gustavocelani/sense_pro/README.md

# Sense Pro

That project was developed in my period of scientific research on CDTTA (Development Center of Assistive Technology) of INATEL.

The propose was develop a open source project of a low coust protesis using 3D printing.
