gustavocelani/sense_pro/Pictures/README.md

# Pictures

There are some general pictures about the project.

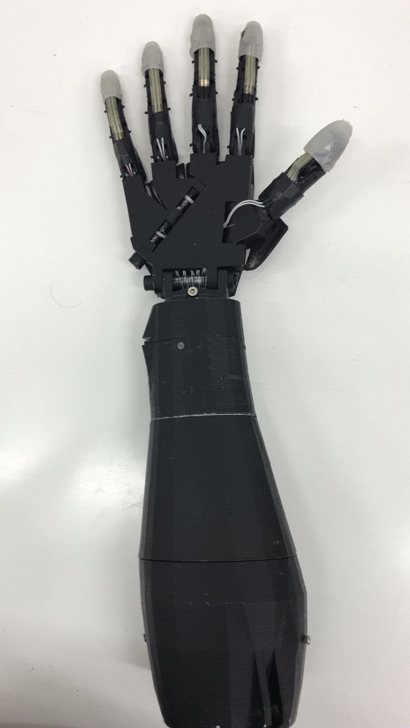
[picture p1: Pictures/Pic_4.jpg]
SensePro Prototype
