gustavocelani/sense_pro/FSR_vs_Piezoeletrico/README.md

# FSR (Force Sensor Resistive) VS Piezoeletric Sensor

That was a study about the differences beetween an FSR and Piezoeletric sensor.

Impiric tests was made to presents this resolts.

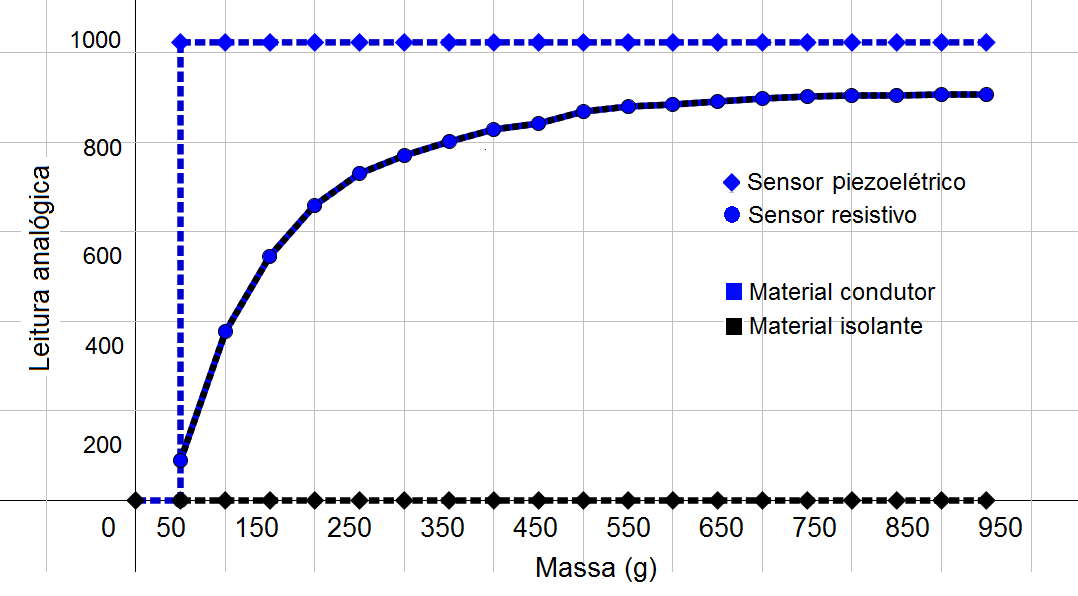
[picture p2: FSR_vs_Piezoeletrico/Comparative.png]
FSR vs Piezoeletric
