gustavocelani/sense_pro/Softwares/Application_Bluetooth_Version/README.md

# Sense Pro - Android Bluetooth Version

To use this software version, install the "SensePro_v05.apk" on your android device and upload "Embedded_Firmware.ino" on your AtMega.
