gustavocelani/sense_pro/Softwares/Sensors_Monitor/README.md

# Sense Pro - Sensors Monitor

This version was used to monitoring all sensors.

To use this software version, upload "Embedded_Firmware.ino" on your AtMega and run "Sensors_Monitor.pde" on your computer.

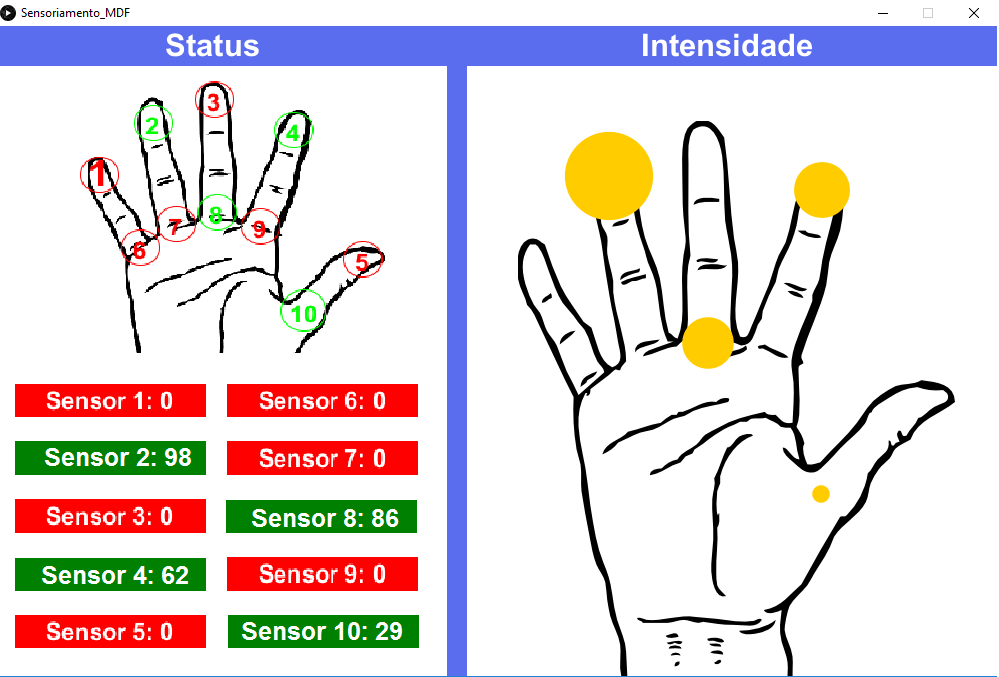
[picture p3: Softwares/Sensors_Monitor/Printscreen.png]
Software
