gustavocelani/sense_pro/Softwares/Status_Commands_Desktop/README.md

# Sense Pro - Status Commands

This version was used to monitoring all sensors status and control the prototype.

To use this software version, upload "Embedded_Firmware.ino" on your AtMega and run "Status_Commands_Desktop_v3.pde" on your computer.

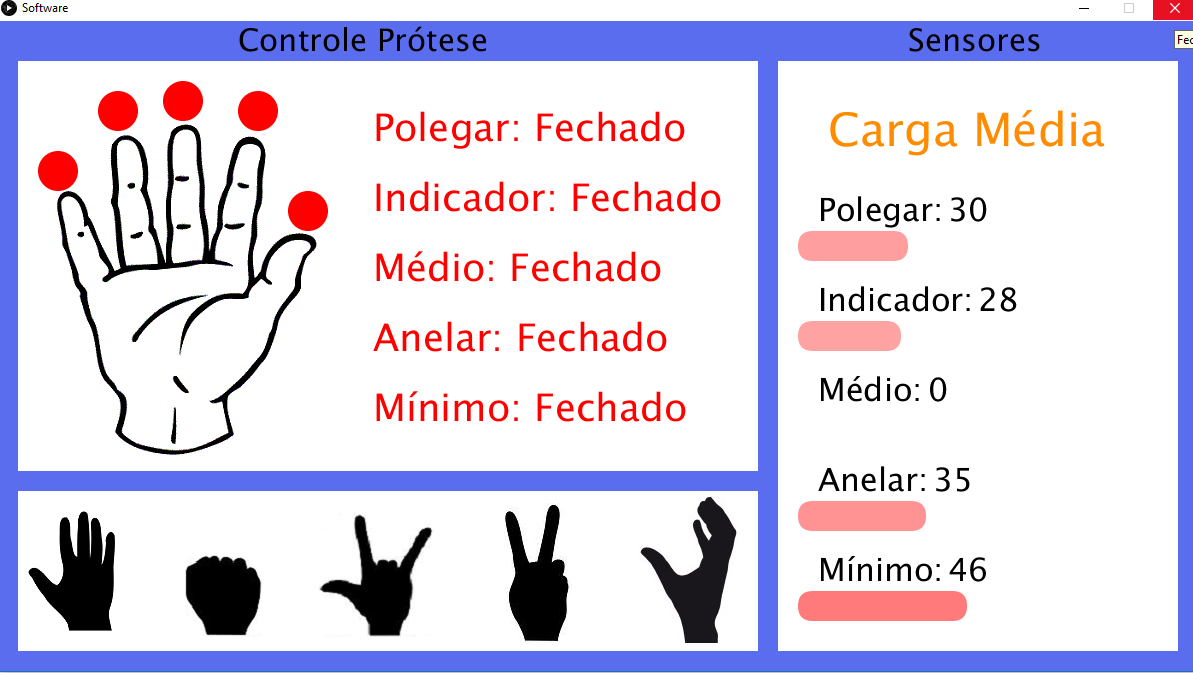
[picture p4: Softwares/Status_Commands_Desktop/Printscreen.png]
Software
