gustavocelani/sense_pro/Softwares/Sensors_Monitor/Sensors_Monitor_v2/README.md

# Sense Pro - Sensors Monitor

```
/* ************************************************************************
 *
 * Tittle: Sensors_Monitor_v2.pde
 *
 * Description:  Monitoring States of Sensors Graphcaly
 *
 * Version:      2
 * Date:         06/02/2016  09:41:02
 * Author:       Gustavo Celani
 * Organization: CDTTA - Centro de Desenvolvimento
 *                       e Transferência de Tencologia Assistiva
 *
 * ***********************************************************************/

```
