gustavocelani/sense_pro/CBEB-Brazilian_Congress_on_Biomedical_Engineering/Lecture_550.pdf

### ADAPTAÇÃO DE UM PROJETO DE ROBÔ HUMANOIDE IMPRESSO EM 3D EM UMA PRÓTESE SENSORIAL DE MEMBRO SUPERIOR

G.P.O. Celani, M.B. Silvério, R.L.A. Pinheiro, F.A. Freitas, F.V. Carvalho, R.S. Alves, F.E.C. Costa, E.R.C. Dester

Centro de Desenvolvimento e Transferência de Tecnologia Assistiva, Instituto Nacional de Telecomunicações Santa Rita do Sapucaí, MG, Brasil

# INTRODUÇÃO

- Primeiras próteses em 200 d.C.;
- Ivan Owen.

## CONEXTO

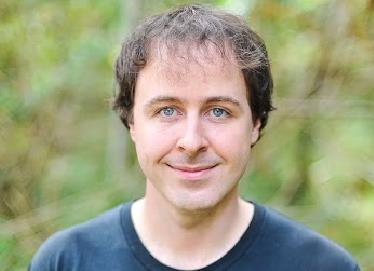
[picture p16: figure]

Ivan Owen - http://enablingthefuture.org/tag/ted-talks/

- Durabilidade;
- Inacessibilidade financeira;
- Função sensitiva.

## PROBLEMAS

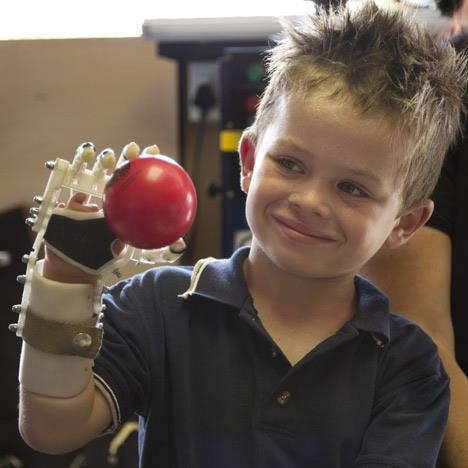
[picture p17: figure]

http://www.3ders.org/articles/20140125-ivan-owen-lifeenhancing-prosthetics-3d-printed-and-open-sourced.html

- Projeto open source INMOOV;
- Adaptação para uma prótese sensorial.

## OBJETIVO

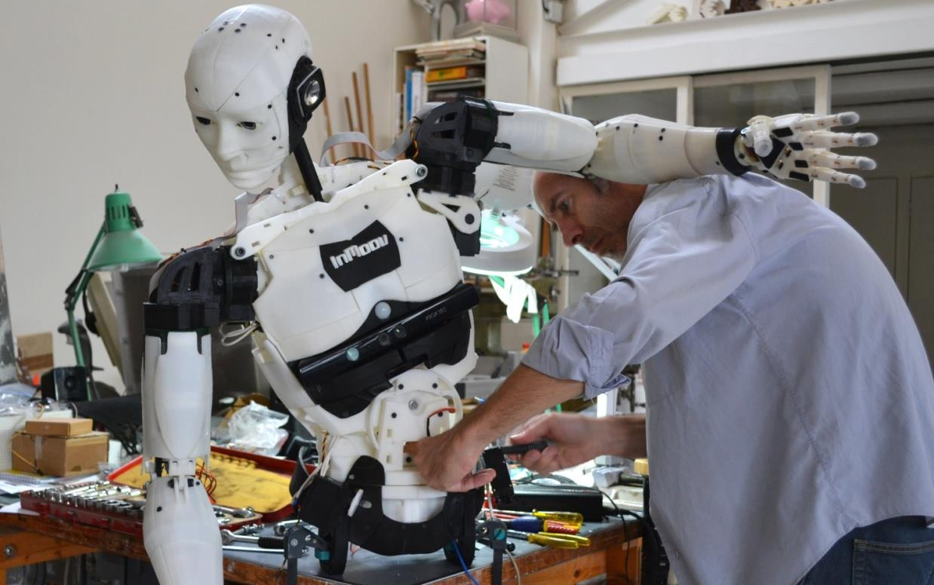
[picture p18: figure]

INMOOV - http://inmoov.fr/mid-stomach/

# MATERIAIS E MÉTODOS

- Material: 884g de ABS;
- Tempo de impressão: 67h;
- Massa: 902g;
- 6 Servo motores;
- Fios de nylon.

## PROTÓTIPO

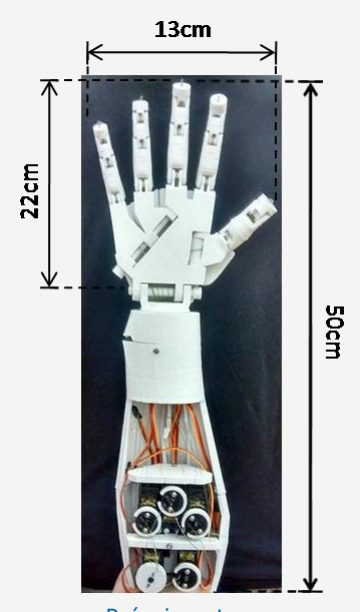
[picture p19: figure]

Próprio autor

- Linguagem: Java;
- Status e intensidade de cada sensor.

## SOFTWARE

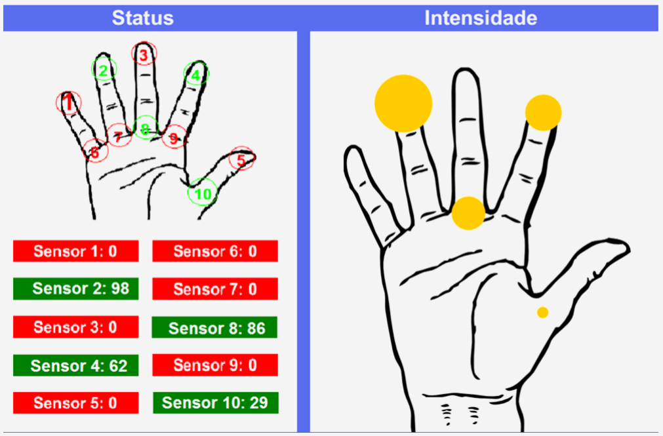
[picture p20: figure]

Próprio autor

- Ortogonal ao chão;
- Sacola de massa desprezível;
- Adição gradual e acumulativa de corpos de 50g;
- Comprimento fios;
- Quintuplicata;
- Chebyshev;
- T-student (p≤0,05).

## RESISTÊNCIA

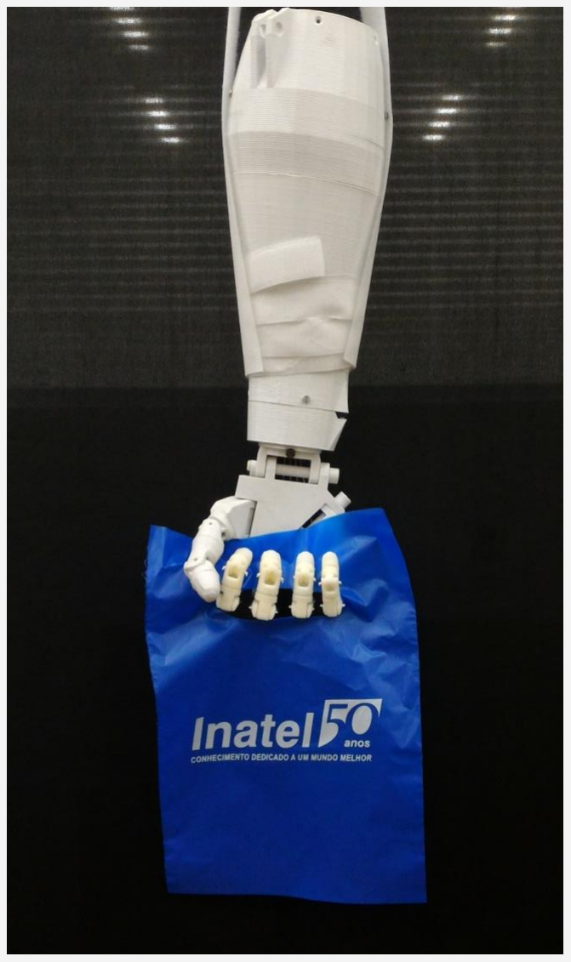
[picture p21: figure]

Próprio autor

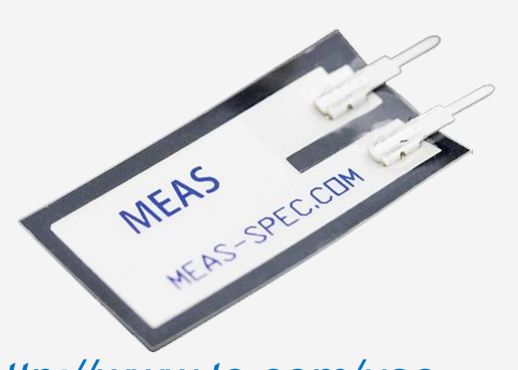
[picture p22: figure]

- Piezoeletrico MEAS®;
- Resistivo InterlinkEletronics®;
- Adição gradual de massas de 50g;
- Leitura analógica;
- Materiais isolantes e
condutores.

## SENSORIAMENTO

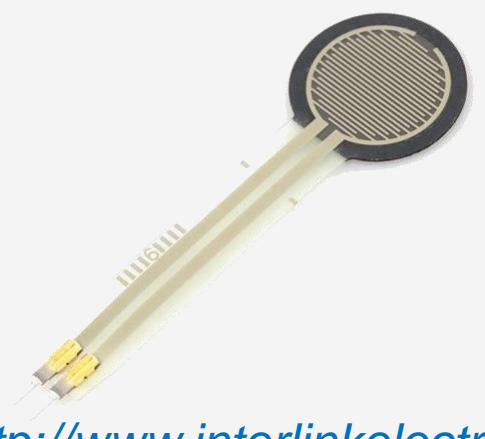
[picture p23: figure]

http://www.interlinkelectronics.com/standardproducts.php

http://www.te.com/usaen/product-CAT-PFS0004.html

# RESULTADOS

Teste | Massa trinc. mínimo (Kg) | Tempo trinc. mínimo (h) | Carga máxima (Kg) | Tempo total (h)
1 | 3,55 | 2:35:10 | 3,95 | 2:59:10
2 | 3,25 | 2:15:17 | 3,50 | 2:30:17
3 | 3,65 | 2:40:25 | 3,90 | 2:55:25
4 | 3,90 | 2:55:02 | 4,10 | 3:07:02
5 | 3,60 | 2:36:35 | 3,85 | 2:51:35

## RESISTÊNCIA

Teste | Massa trinc. mínimo (Kg) | Tempo trinc. mínimo (h) | Carga máxima (Kg) | Tempo total (h)
1 | 3,55 | 2:35:10 | 3,95 | 2:59:10
2 | 3,25 | 2:15:17 | 3,50 | 2:30:17
3 | 3,65 | 2:40:25 | 3,90 | 2:55:25
4 | 3,90 | 2:55:02 | 4,10 | 3:07:02
5 | 3,60 | 2:36:35 | 3,85 | 2:51:35

## RESISTÊNCIA

- Carga média suportada: 3,86Kg ± 0,22Kg;
- Tempo médio: 2h52min42s ± 13min46s;
- Confiabilidade:
89,48%
(Chebyshev)

## RESISTÊNCIA

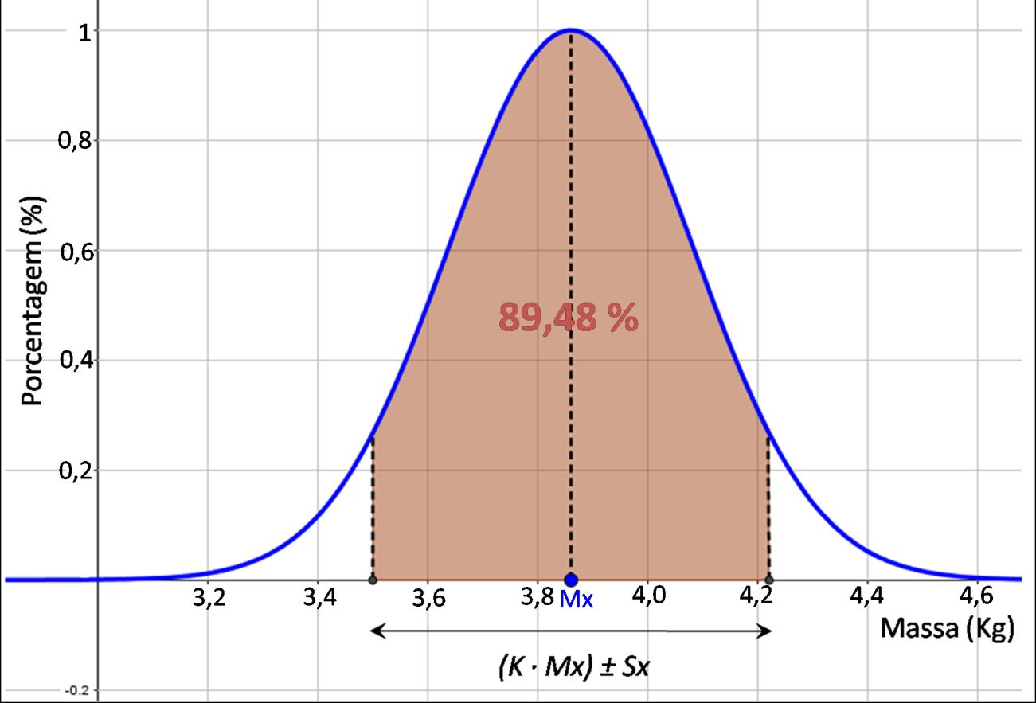
[picture p24: figure]

Próprio autor

- Comportamento logarítmico;

## SENSORIAMENTO

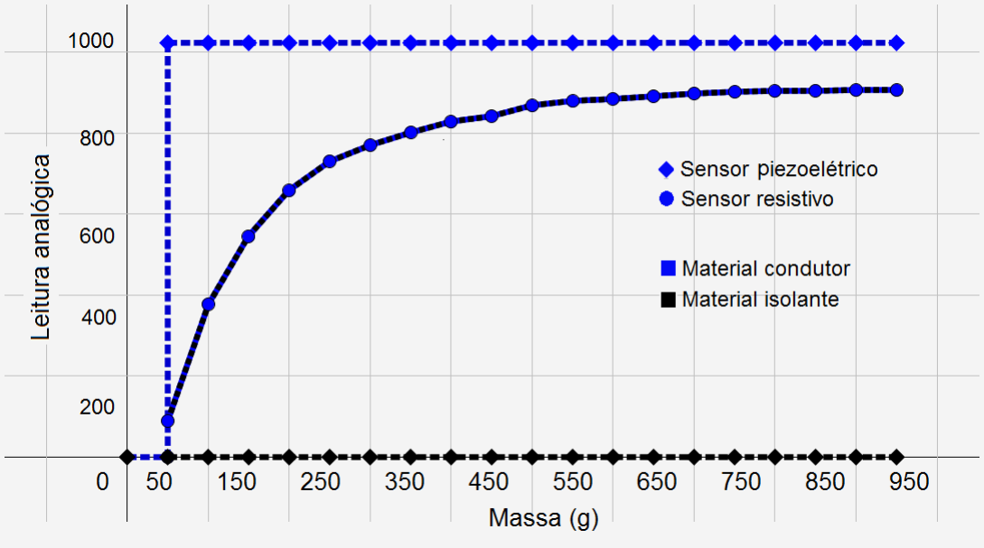
[picture p25: figure]

- Sensor escolhido: resistivo.

Próprio autor

# DISCUSSÃO

- Parâmetros de impressão:
- Densidade: 30% para 80%;
- Espessura: 0,84mm a 1,68mm;
- Distribuição desigual
de carga;
- Baixa resistência;
- Precisão dos dedos;
- Precisão dos sensores.

## DISCUSSÃO

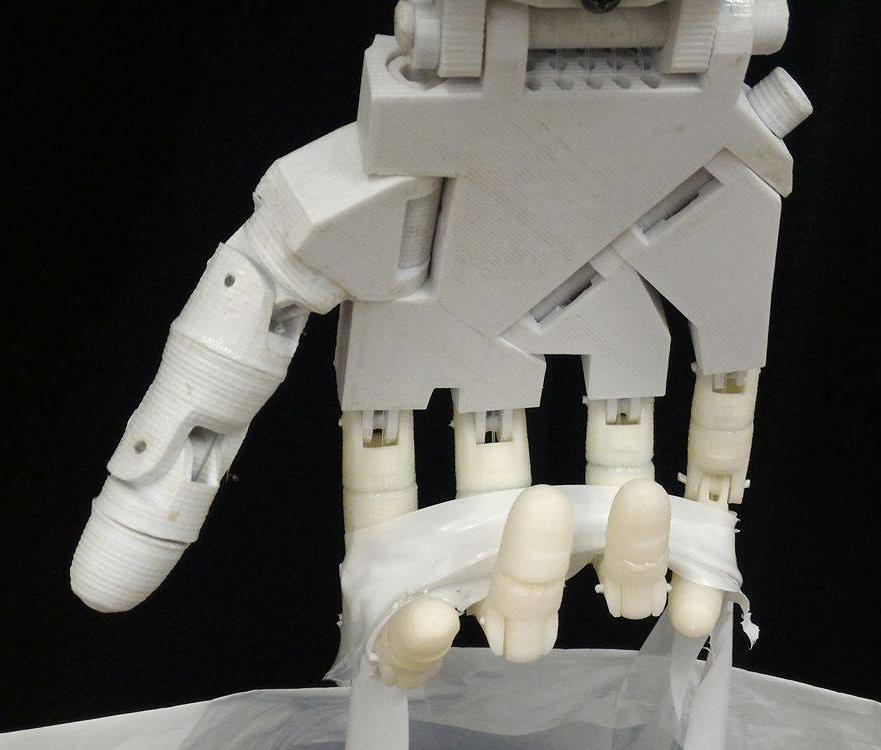
[picture p26: figure]

Próprio autor

# CONCLUSÃO

- Melhorias necessárias:
- Massa total;
- Baixa resistência;
- Software;
- Novos testes:
- Resistência mecânica;
- Massa;
- Funcionalidade.

## CONCLUSÃO

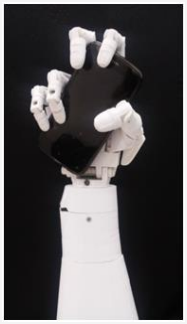
[picture p27: figure]

Próprio autor

- Feedback sensitivo utilizando estimulação eletrotátil;
- Sistema | de | controle
eletromiográfico;
- Confecção | de | um | novo
protótipo aprimorado.

## TRABALHOS FUTUROS

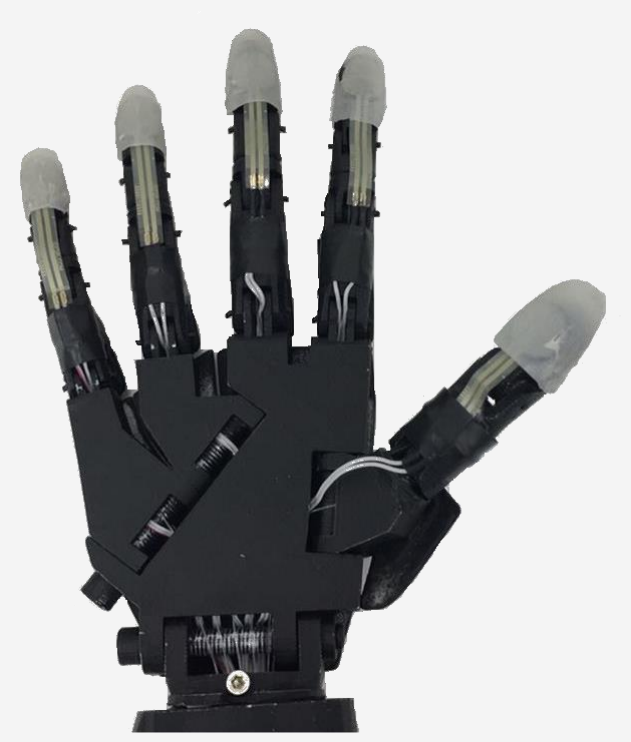
[picture p28: figure]

Próprio autor

## AGRADECIMENTOS

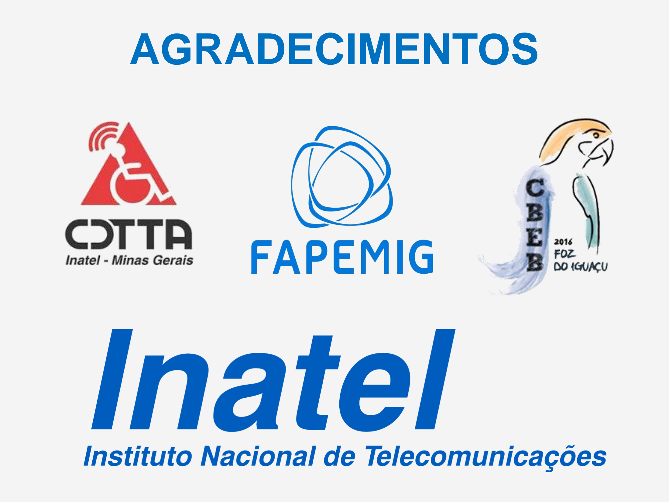
[picture p29: page 21]

## PERGUNTAS ?

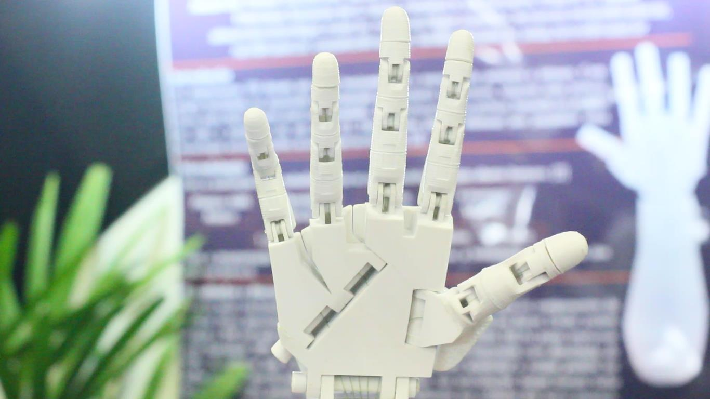
[picture p30: figure]

Próprio autor
