gustavocelani/sense_pro/Softwares/Application_Bluetooth_Version/Embedded_Firmware/README.md

# Bluetooth Version Embedded Firmware

```
/* **********************************************************************
 *
 * Tittle: Firmware_Bluetooth.ino
 *
 * Description:  SensePro Bluetooth Version v5 Firmware
 *
 * Version:      5
 * Date:         19/10/2016  19:21:46
 * Author:       Gustavo Celani
 * Organization: CDTTA - Centro de Desenvolvimento
 *               e Transferência de Tencologia Assistiva
 *
 * *********************************************************************/

```
