gustavocelani/sense_pro/Softwares/Status_Commands_Desktop/Status_Commands_Desktop_v3/README.md

# Sense Pro - Status Commands Desktop

```
/* **********************************************************************************
 *
 * Tittle: Status_Commands_Desktop_v3.pde
 *
 * Description:  Monitoring States of Sensors and Command SensePro Graphcaly
 *
 * Version:      3
 * Date:         25/09/2016  11:17:32
 * Author:       Gustavo Celani
 * Organization: CDTTA - Centro de Desenvolvimento
 *               e Transferência de Tencologia Assistiva
 *
 * *********************************************************************************/

```
