gustavocelani/sense_pro/Softwares/Application_Bluetooth_Version/Android_App/README.md

# Sense Pro - Android Bluetooth App

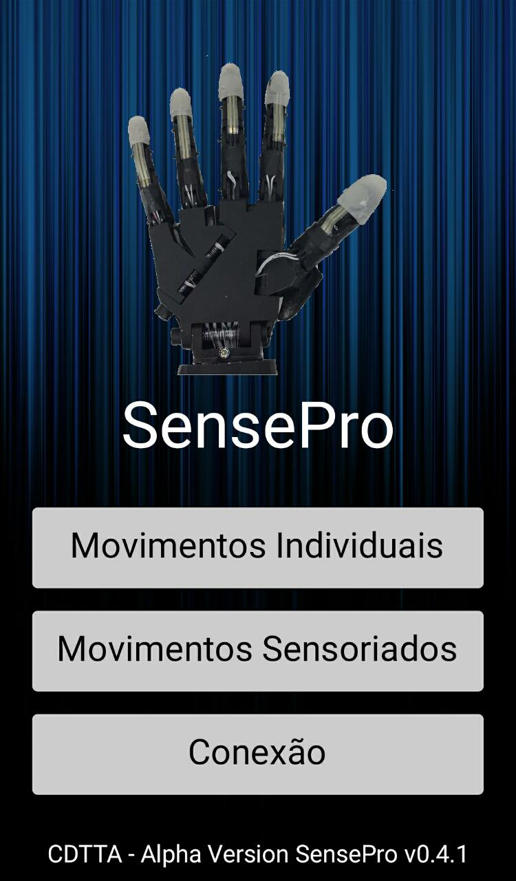
[picture p32: Softwares/Application_Bluetooth_Version/Android_App/App_Menu.jpeg]
App Menu


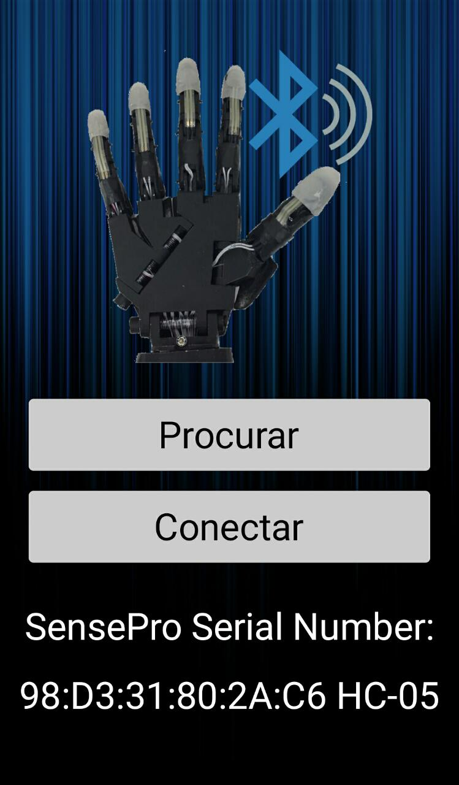
[picture p33: Softwares/Application_Bluetooth_Version/Android_App/App_BT_Connection.jpeg]
App Connection
