gustavocelani/sense_pro/CBEB-Brazilian_Congress_on_Biomedical_Engineering/CopyRight_550.pdf

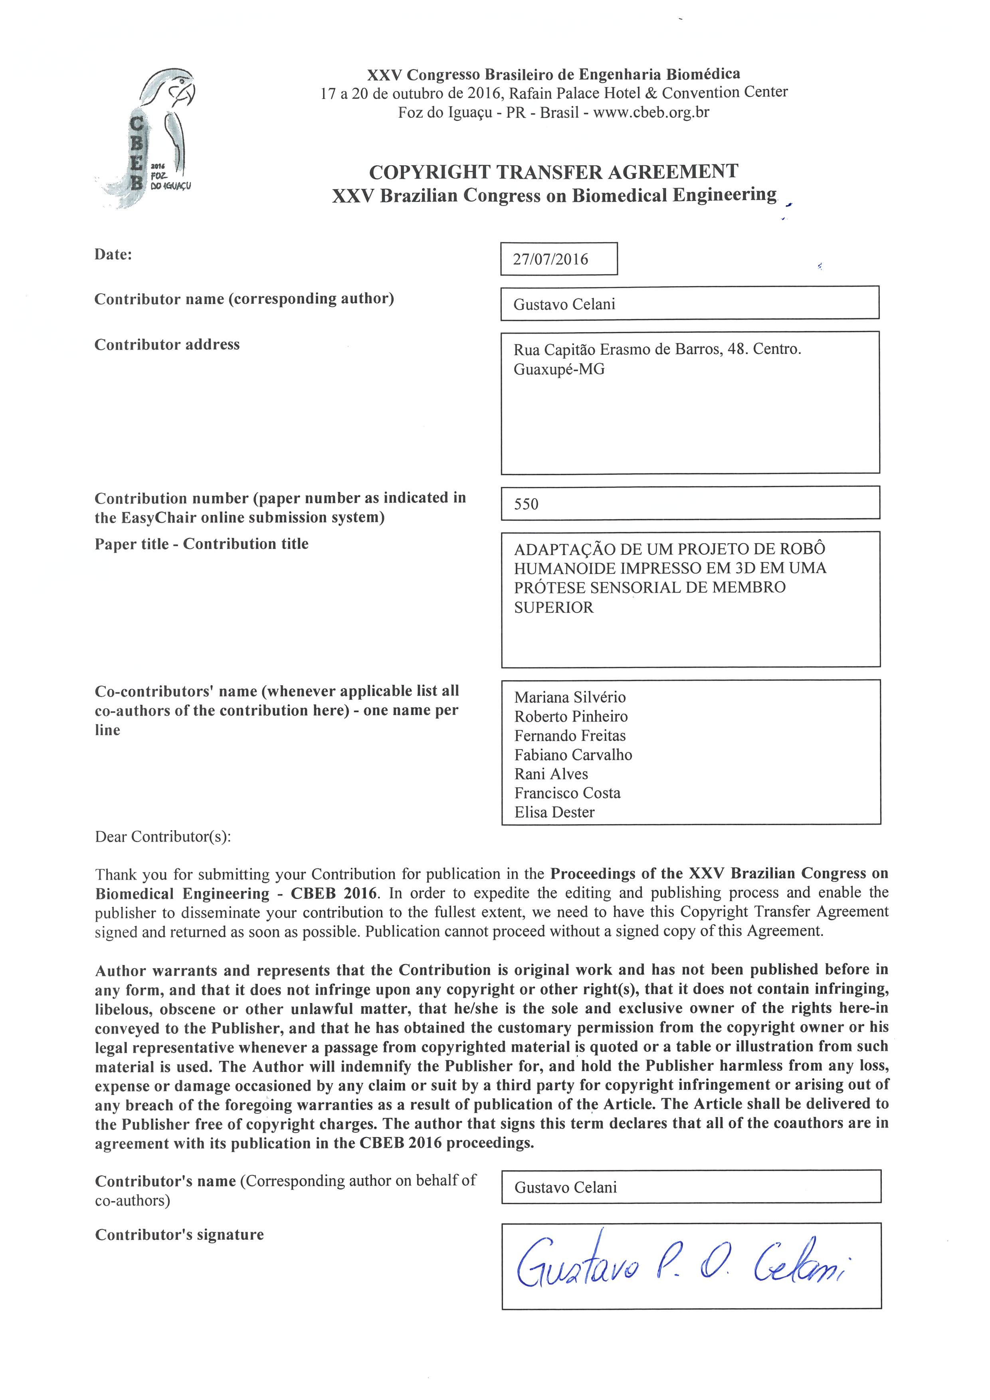
[picture p34: page 1]
