gustavocelani/sense_pro/CBEB-Brazilian_Congress_on_Biomedical_Engineering/Participation_Certify.pdf

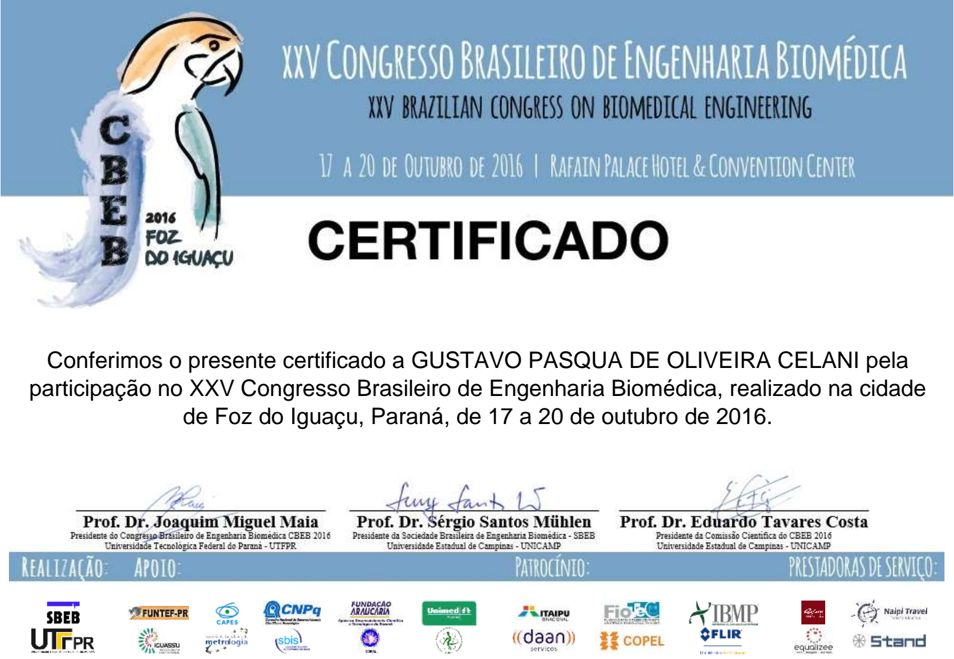
[picture p35: page 1]

Conferimos o presente certificado a GUSTAVO PASQUA DE OLIVEIRA CELANI pela participação no XXV Congresso Brasileiro de Engenharia Biomédica, realizado na cidade de Foz do Iguaçu, Paraná, de 17 a 20 de outubro de 2016.
