gustavocelani/sense_pro/CBEB-Brazilian_Congress_on_Biomedical_Engineering/Publication_Certify.pdf

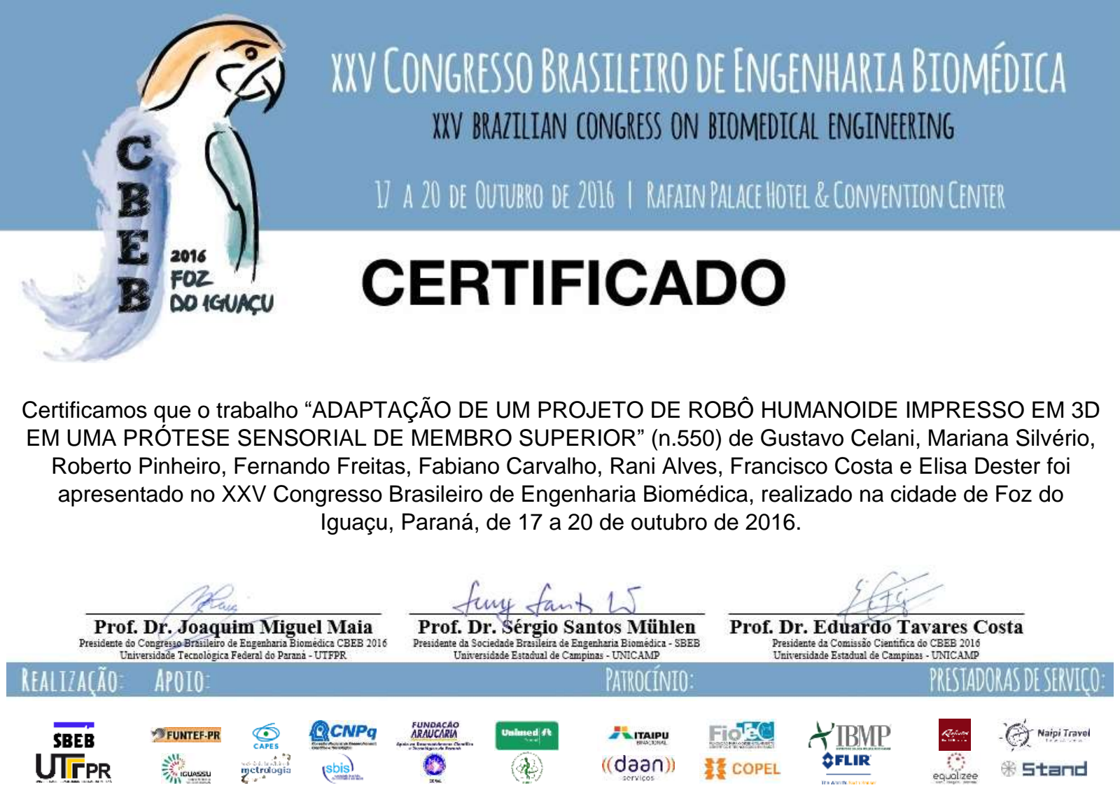
[picture p36: page 1]

Certificamos que o trabalho “ADAPTAÇÃO DE UM PROJETO DE ROBÔ HUMANOIDE IMPRESSO EM 3D EM UMA PRÓTESE SENSORIAL DE MEMBRO SUPERIOR” (n.550) de Gustavo Celani, Mariana Silvério, Roberto Pinheiro, Fernando Freitas, Fabiano Carvalho, Rani Alves, Francisco Costa e Elisa Dester foi apresentado no XXV Congresso Brasileiro de Engenharia Biomédica, realizado na cidade de Foz do Iguaçu, Paraná, de 17 a 20 de outubro de 2016.
