gustavocelani/sense_pro/FSR_vs_Piezoeletrico/Piezoeletrico.png

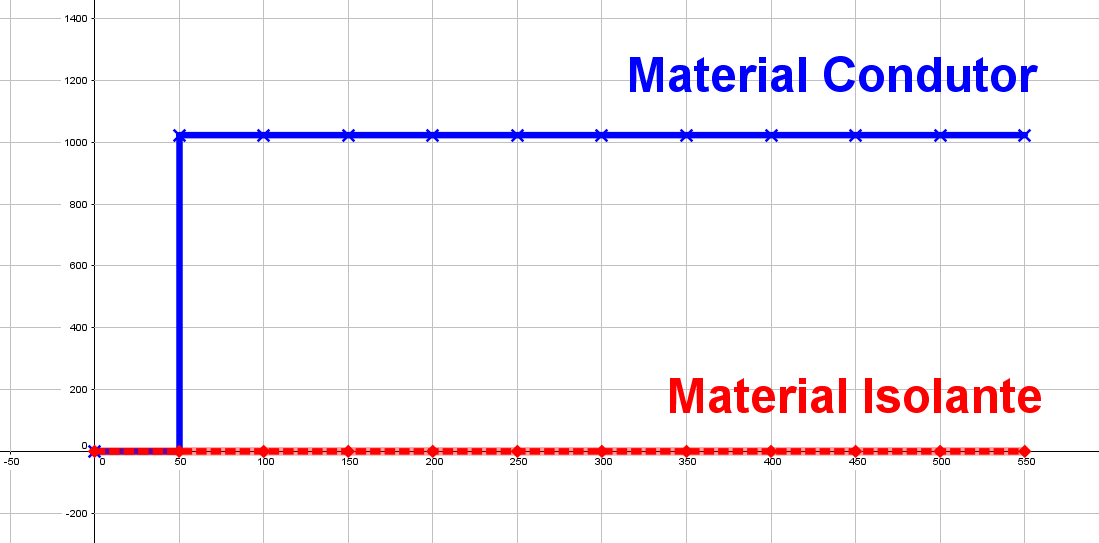
FSR_vs_Piezoeletrico/Piezoeletrico.png
