gustavocelani/sense_pro/FSR_vs_Piezoeletrico/Resistive.png

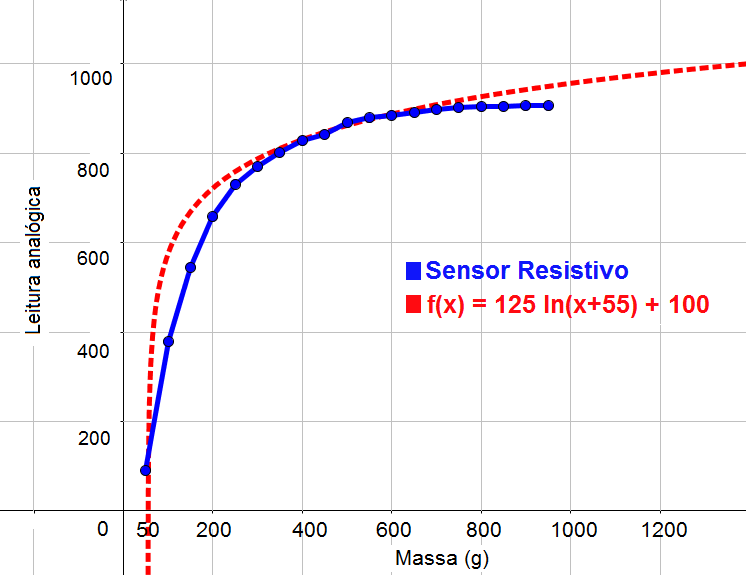
FSR_vs_Piezoeletrico/Resistive.png
