gustavocelani/sense_pro/Pictures/Pic_2.jpg

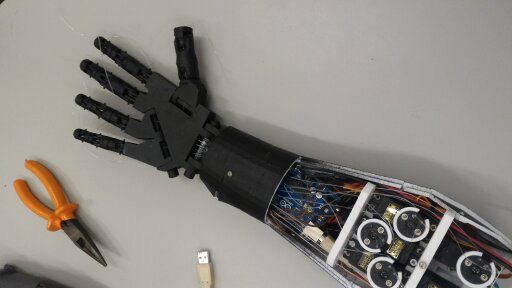
Pictures/Pic_2.jpg
