gustavocelani/sense_pro/Pictures/Pic_3.jpg

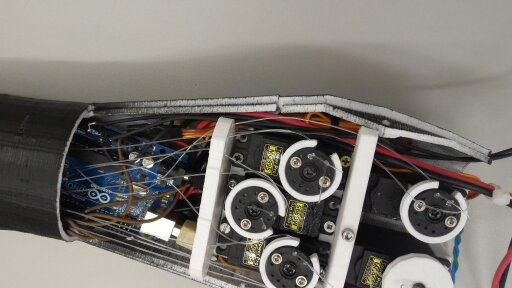
Pictures/Pic_3.jpg
