gustavocelani/sense_pro/Pictures/Pic_5.jpg

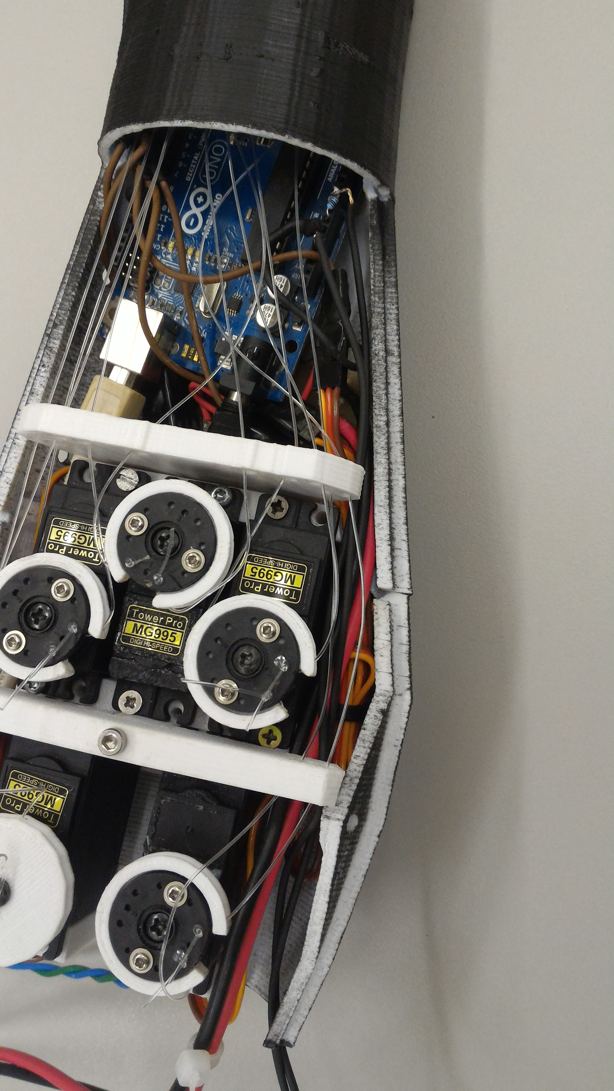
Pictures/Pic_5.jpg
