gustavocelani/sense_pro/Pictures/Pic_6.jpg

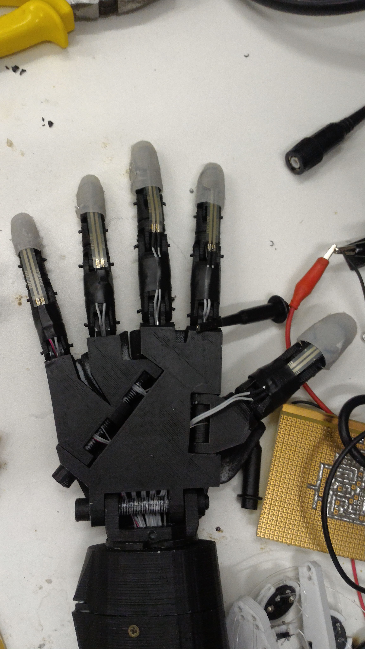
Pictures/Pic_6.jpg
