gustavocelani/sense_pro/Pictures/Pic_7.png

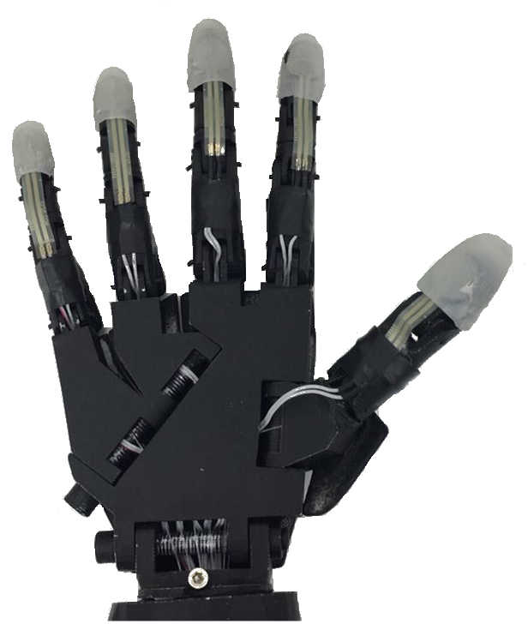
Pictures/Pic_7.png
