gustavocelani/sense_pro/Pictures/Pic_8.png

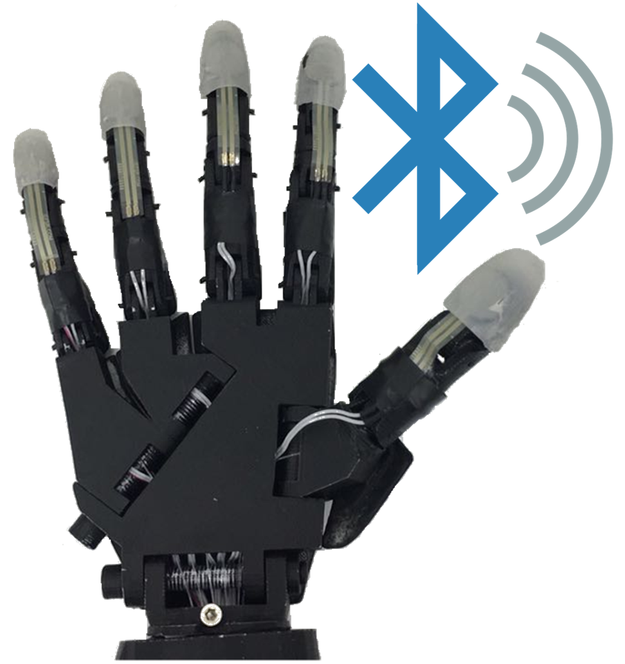
Pictures/Pic_8.png
