gustavocelani/sense_pro/Softwares/Events_Presentation/Events_Presentation_v3/CompleteHand.gif

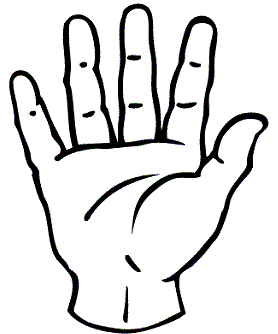
Softwares/Events_Presentation/Events_Presentation_v3/CompleteHand.gif
