gustavocelani/sense_pro/Softwares/Events_Presentation/Events_Presentation_v3/Rock.png

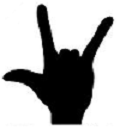
Softwares/Events_Presentation/Events_Presentation_v3/Rock.png
