gustavocelani/sense_pro/Softwares/Sensors_Monitor/Sensors_Monitor_v2/background.png

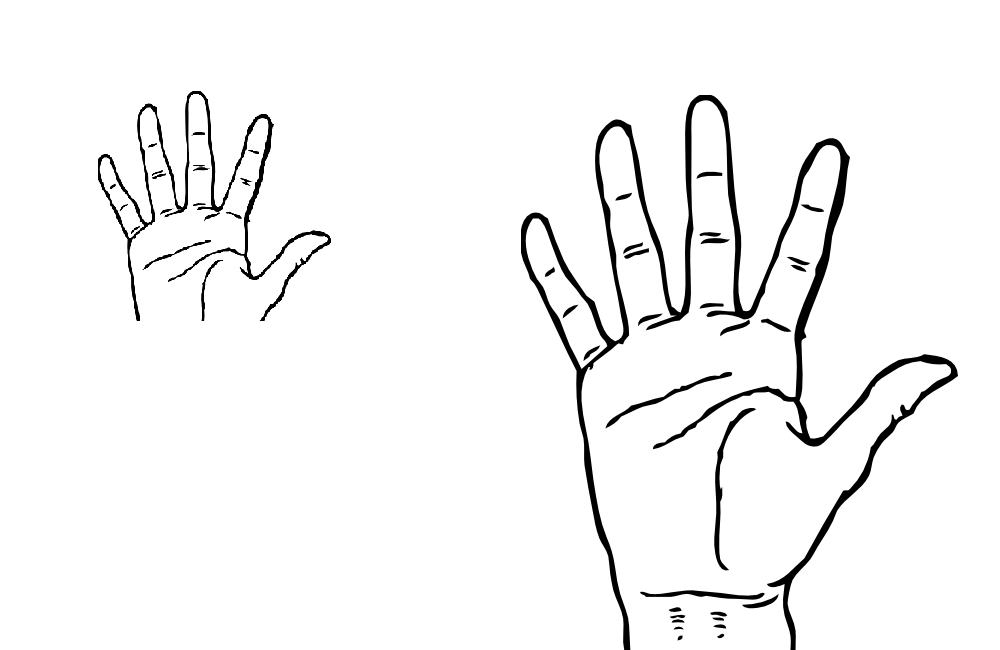
Softwares/Sensors_Monitor/Sensors_Monitor_v2/background.png
