gustavocelani/sense_pro/Mechanical_Test/Pictures/README.md

# Pictures

There are some test pictures.
