gustavocelani/sense_pro/Mechanical_Test/Pictures/Test_0.jpg

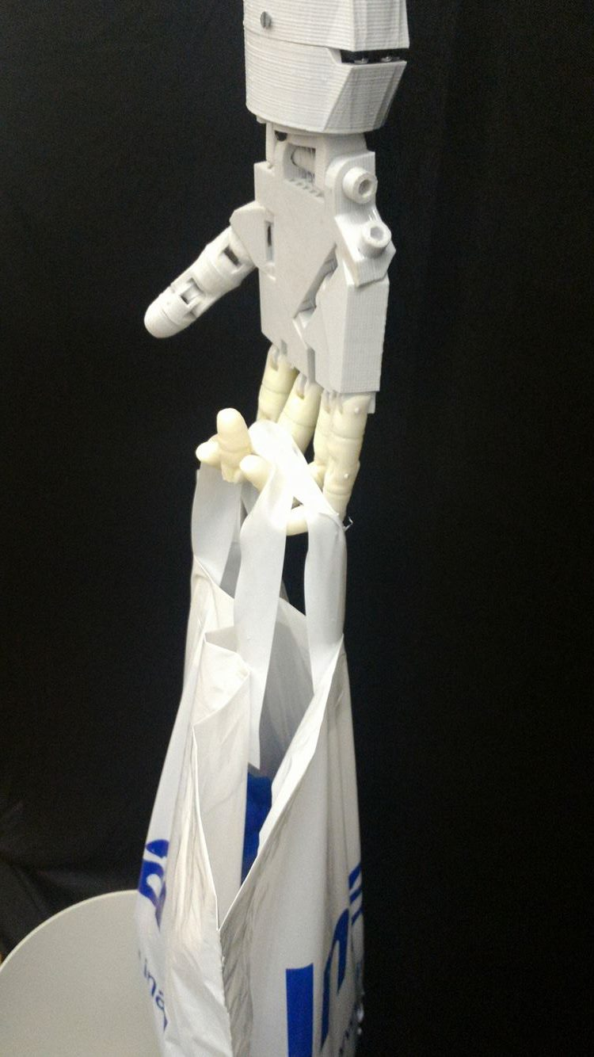
Mechanical_Test/Pictures/Test_0.jpg
