gustavocelani/sense_pro/Mechanical_Test/Pictures/Test_1.jpg

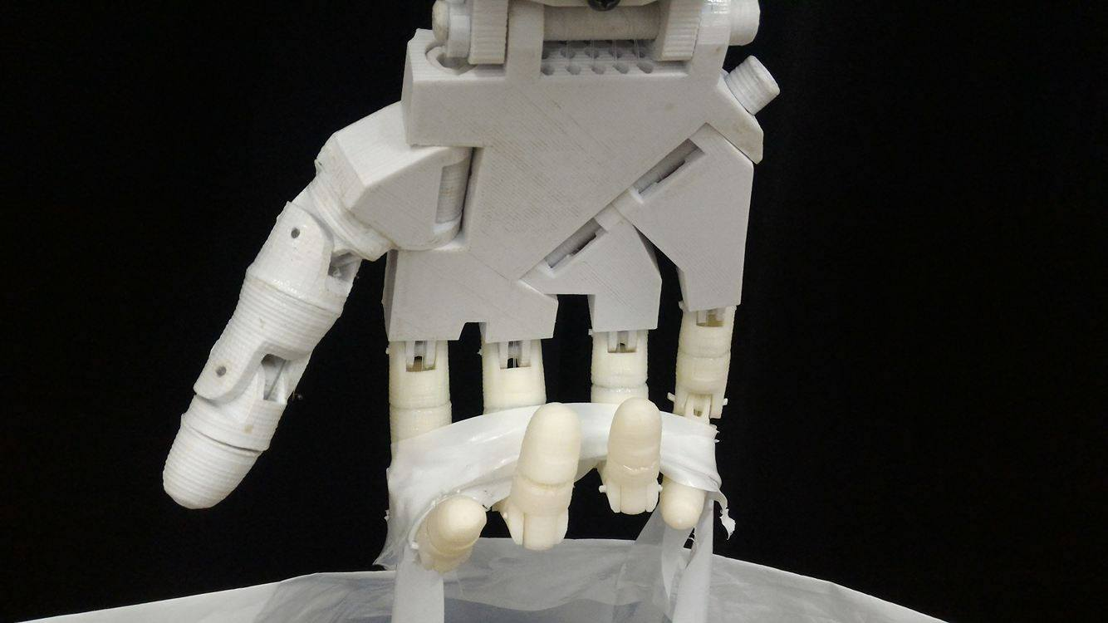
Mechanical_Test/Pictures/Test_1.jpg
