gustavocelani/sense_pro/Mechanical_Test/Pictures/Test_2.jpg

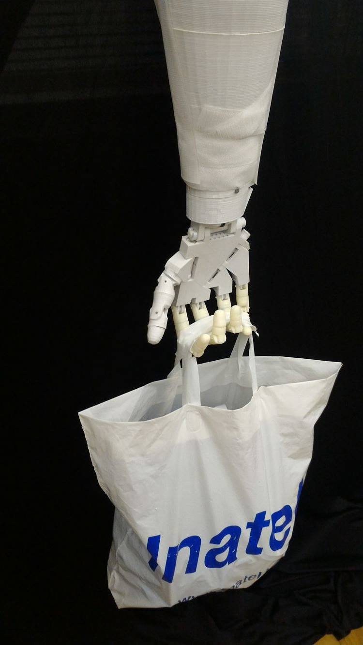
Mechanical_Test/Pictures/Test_2.jpg
