gustavocelani/sense_pro/Mechanical_Test/Pictures/Test_3.jpg

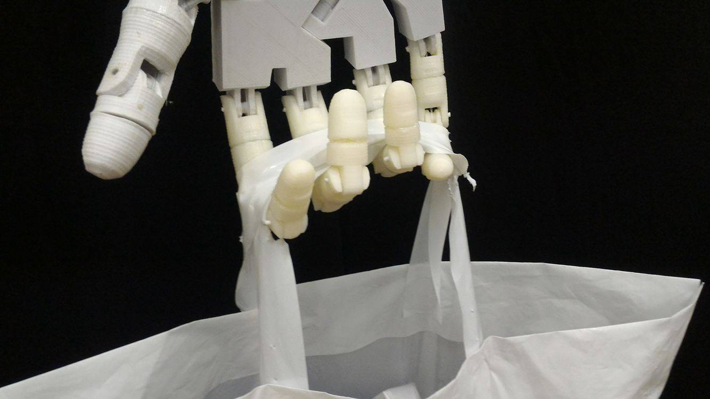
Mechanical_Test/Pictures/Test_3.jpg
